walters5/Intercom/README.md

# Intercom
This is an intercom system that will be able to communicate back and forth between multiple auxiliary units.
