walters5/Intercom/Weekly Project Report (WK 10).docx

WEEKLY PROJECT REPORT (WEEK 10 – 11/28)

I. Last Week:
- Completely soldered three boards (master and slave modules)
- Tested the audio codec
- Continue programming for button
- Implemented communication between both slave and master boards
II. Next Week:
- Try finishing code for buttons
- Testing systems
- Prepare for presentation and demo
III. Issue:
- Unable to write code for channel buttons.
