walters5/Intercom/Weekly Project Report (WK 9).docx

WEEKLY PROJECT REPORT (WEEK 9 – 11/21)

I. Last Week:
- Successfully got clock signal out and make it turn on/off
- Received two boards back.
- Worked on coding for the LED and button.
- Started to solder components on the boards
II. Next Week:
- Finish soldering components
- Finish code for LED and button
III. Issue:
- No significant issue for this week.
