walters5/Intercom/Weekly Report Project (WK 8).docx

Weekly Report Project (Week 8 – 11/14)

I. Last week:
- Submitted schematic and layout
- Corrected error follow feedback from Professor Greenberg
- Already order the boards through PCB Unlimited
- Initialized all the pins on the microcontroller
II. Next week:
- Start to solder components on the boar
- Verify code functions
III. Issue:
- Unable programing to control clock signals
