walters5/Intercom/Weekly Project Report (WK 6).docx

Weekly Project Report (Week 6)

1. Last Week:
- Continued writing C code to make master device to read corresponding data from slave
- Working on schematic and PCB layout
2. Next Week:
- Finish PCB layout and check error
- Finish programming to make master-slave device connect
3. Issue:
- Need to find another library for programming the boards.
