walters5/Intercom/Weekly Project Report (WK 7).docx

Weekly Project Report (Week 7)

1. Last Week:
- We finished programming to make the master and slave connect together, then process debugging to test.
- PCB layout was finished and passed all ERC checks.
- Schematics is done
2. Next Week:
- Finish debugging master-slave
- Make microphone and speaker work corresponding to microcontroller
3. Issue:
- Re-refigured wiring between master and slave board
