walters5/Intercom/Weekly Project Report (WK 2).docx

Weekly Project Report (Week 2 – 10/08)

1. Last week:
- Completed brainstorm design for project and component choices (Chose microphone selection and Cat cable
- Clarified three terms: Must, Should, May

Must | Should | May
Two intercoms | Multiple Intercoms Unit | Wireless
Push-to-Talk | Full duplex | LCD Display Screen
Volume Control
Microphone
Speaker

- Reviewed and understand characteristic of several components: Audio codec, SPI-allows accessing, DAC, ADC.
- Estimated budget project: $30/person
- Completed homework 1: Resume (working individual).
2. Next week:
- Discuss about homework 2: project proposal.
- Complete reading practicum project.
- Decide microprocessor, standard packet size and initial cost
- Researching types of audio
- Find out where mentor graphics is accessible
3. Issue:
- Unable to get microphone selection.
