walters5/Intercom/Weekly Project Report (WK 3).docx

Weekly Project Report (Week 3 – 10/15)

1. Last week:
- Review and submit homework 2
- Figure out mentor graphic is available in Inter lab
- Discuss about project proposal
- Completed the draft for Design Architecture
- Standard packet size will not exceed 5”x5”x5”
2. Next week
- Discuss and review about Design Architecture.
- Decide which program is used to make schematic capture.
3. Issue:
- Unable to choose microcontroller
- Unable to choose types of audio
