walters5/Intercom/T-06 BOM.xlsx

Sheet: Consolidated, NO DNIs
T-06 Intercom Revised: Tuesday, November 29, 2016
1.) T-06 INTERCOM Revision: A |  |  |  | *Line cost uses unit build quantities of less than 10.
Bill Of Materials November 30,2016 0:57:27
Item | Quantity | Line Cost* | Reference | Part | PCB Footprint | DK | Manu | Manu PN
______________________________________________
1 | 13 | $1.30 | C1,C2,C3,C10,C11,C12,C13, | 0.1uF 16V | 0603 | 399-1096-1 | KEMET | C0603C104K4RACTU
 |  | $0.00 | C14,C15,C22,C23,C24,C25
2 | 1 | $0.10 | C4 | .01uF | 0603 | 1276-1919-1-ND | Samsung | CL10B103KA8NFNC
3 | 1 | $0.11 | C5 | 1uF | 0603 | 445-1604-1-ND | TDK | C1608X7R1C105K080AC
4 | 1 | $0.15 | C8 | 10uF 6.3V | 0603 | 490-6405-1 | MURATA | GRM188R60J106ME47J
5 | 3 | $1.29 | C9,C20,C21 | 47uF 6.3V | 0603 | 1276-6823-1-ND | MURATA | CL10A476MQENRE
6 | 3 | $0.81 | D1,D8,D9 | C190GKT | 0603_LED | 160-1183-1 | LITE-ON | LTST-C190GKT
7 | 6 | $1.62 | D2,D3,D4,D5,D6,D7 | C190KRKT | 0603_LED | 160-1436-1-ND | LITE-ON | LTST-C190KRKT
8 | 1 | $0.13 | F1 | 0.25_AMP | 1206 | 507-1799-1-ND | BEL FUSE | 0ZCJ0025AF2E
9 | 1 | $1.38 | J3 | 10K | POT-EVUF | P3G7103-ND | PANASONIC | EVU-F2MFL3B14
10 | 1 | $0.28 | J6 | H2X2 | H2X2 | S2012E-18-ND(partial) | SULLINS | PEC18DAAN
11 | 2 | $2.10 | J8,J7 | RJ45 | RJ45-A-2004-2-4-lps | AE10387-ND | Assmann | A-2004-2-4-LPS-N-R
12 | 1 | $0.39 | L1 | 10uH | 1210 | 490-5340-1-ND | MURATA | LQH32PN100MN0L
13 | 8 | $0.80 | P2,P5,P8,P9,P19,P20,P21, | H3 | H3 | S1012E-36-ND (partial) | SULLINS | PEC36SAAN
 |  | $0.00 | P22
14 | 7 | $0.20 | P3,P6,P10,P11,P12,P23, | H2 | H2 | S1012E-36-ND (partial) | SULLINS | PEC36SAAN
 |  | $0.00 | P24
15 | 1 | $1.05 | P4 | CMB-6544PF | MIC-CMB-6544PF | 102-1722-ND | CUI INC. | CMB-6544PF
16 | 1 | $3.53 | P7 | SPEAKER | SPKR-AST-030C0MR-R | 668-1138-ND | PUI AUDIO | AST-030C0MR-R
17 | 5 | $0.50 | R4,R5,R6,R40,R42 | 10.0K | 0603 | P10.0KHCT | PANASONIC | ERJ-3EKF1002V
18 | 3 | $0.30 | R7,R8,R38 | 0 | 0603 | P0.0GCT-ND | PANASONIC | ERJ-3GEY0R00V
19 | 2 | $0.20 | R10,R9 | 33 | 0603 | P33GCT-ND | PANASONIC | ERJ-3GEYJ330V
20 | 8 | $0.80 | R11,R12,R13,R14,R15,R16, | 3.3K | 0603 | P3.30KHCT-ND | PANASONIC | ERJ-3EKF3301V
 |  | $0.00 | R17,R19
21 | 2 | $0.20 | R32,R18 | 4.87K 1% | 0603 | P4.87KHCT | PANASONIC | ERJ-3EKF4871V
22 | 4 | $0.40 | R20,R21,R39,R41 | 100 | 0603 | P100HCT-ND | PANASONIC | ERJ-3EKF1000V
23 | 7 | $3.01 | S1,S2,S3,S4,S5,S6,S8 | SWITCH | SW-TL3301-G | EG4375CT-ND | E-SWITCH | TL3301FF160QG
24 | 1 | $0.88 | S7 | SW_DIP6 | DIPSW6 | 450-1359 | TE CONNECTIVITY | 1825002-9
25 | 1 | $2.29 | U1 | Si3000 | SO16NB | 336-1382-ND | SILICON LABS | SI3000-C-FS
26 | 1 | $4.51 | U2 | STM32L053R8 | QFP64-0.5 | 497-14654-ND | STMICRO | STM32L053R8T6
27 | 1 | $0.46 | U3 | NCP1117ST33T3G | SOT223 | NCP1117ST33T3GOSCT | ON SEMI | NCP1117ST33T3G
28 |  | $0.00 | U4 | SN65LVDS050PW | TSSOP20 | 296-12051-5-ND | TI | SN65LVDS050PW
29 | 1 | $0.43 | U12 | SN74LV245APWR | TSSOP20 | 296-3809-1-ND | TI | SN74LV245APWR
30 | 1 | $18.00 | N/A | PCB
PARTS |  | $29.22
PCB |  | $18.00
TOTAL PER UNIT: |  | $47.22

Sheet: Sheet2
T-06 Intercom Revised: Tuesday, November 29, 2016
1.) T-06 INTERCOM Revision: A |  |  | *Line cost uses unit build quantities of less than 10.
Bill Of Materials November 30,2016 0:57:27
Item | Quantity | Line Cost* | Part | PCB Footprint
______________________________________________
1 | 13 | $1.30 | 0.1uF 16V | 0603
 |  | $0.00
2 | 1 | $0.10 | .01uF | 0603
3 | 1 | $0.11 | 1uF | 0603
4 | 1 | $0.15 | 10uF 6.3V | 0603
5 | 3 | $1.29 | 47uF 6.3V | 0603
6 | 3 | $0.81 | C190GKT | 0603_LED
7 | 6 | $1.62 | C190KRKT | 0603_LED
8 | 1 | $0.13 | 0.25_AMP | 1206
9 | 1 | $1.38 | 10K | POT-EVUF
10 | 1 | $0.28 | H2X2 | H2X2
11 | 2 | $2.10 | RJ45 | RJ45-A-2004-2-4-lps
12 | 1 | $0.39 | 10uH | 1210
13 | 8 | $0.80 | H3 | H3
 |  | $0.00
14 | 7 | $0.20 | H2 | H2
 |  | $0.00
15 | 1 | $1.05 | CMB-6544PF | MIC-CMB-6544PF
16 | 1 | $3.53 | SPEAKER | SPKR-AST-030C0MR-R
17 | 5 | $0.50 | 10.0K | 0603
18 | 3 | $0.30 | 0 | 0603
19 | 2 | $0.20 | 33 | 0603
20 | 8 | $0.80 | 3.3K | 0603
 |  | $0.00
21 | 2 | $0.20 | 4.87K 1% | 0603
22 | 4 | $0.40 | 100 | 0603
23 | 7 | $3.01 | SWITCH | SW-TL3301-G
24 | 1 | $0.88 | SW_DIP6 | DIPSW6
25 | 1 | $2.29 | Si3000 | SO16NB
26 | 1 | $4.51 | STM32L053R8 | QFP64-0.5
27 | 1 | $0.46 | NCP1117ST33T3G | SOT223
28 |  | $0.00 | SN65LVDS050PW | TSSOP20
29 | 1 | $0.43 | SN74LV245APWR | TSSOP20
30 | 1 | $18.00 | PCB
PARTS |  | $29.22
PCB |  | $18.00
TOTAL PER UNIT: |  | $47.22

Sheet: T06-SCHEMATIC-INTERCOM-REVA
T-06 Intercom Revised: Tuesday, November 29, 2016
1.) T-06 INTERCOM Revision: A
Bill Of Materials November 30,2016 0:57:27
Item | Quantity | Reference | Part | PCB Footprint | DK | Manu | Manu PN
______________________________________________
1 | 13 | C1,C2,C3,C10,C11,C12,C13, | 0.1uF 16V | 603 | 399-1096-1 | KEMET | C0603C104K4RACTU
 |  | C14,C15,C22,C23,C24,C25
2 | 1 | C4 | .01uF | 603 | 1276-1919-1-ND | Samsung | CL10B103KA8NFNC
3 | 1 | C5 | 1uF | 603 | 445-1604-1-ND | TDK | C1608X7R1C105K080AC
4 | 27 | R1,R2,R3,C6,C7,D10,D11, | DNI | 603
 |  | C16,C17,C18,C19,R22,R23,
 |  | R24,R25,R26,C26,R27,R28,
 |  | R29,R30,R31,R33,R34,R35,
 |  | R36,R37
5 | 1 | C8 | 10uF 6.3V | 603 | 490-6405-1 | MURATA | GRM188R60J106ME47J
6 | 3 | C9,C20,C21 | 47uF 6.3V | 603 | 1276-6823-1-ND | MURATA | CL10A476MQENRE
7 | 3 | D1,D8,D9 | C190GKT | 0603_LED | 160-1183-1 | LITE-ON | LTST-C190GKT
8 | 6 | D2,D3,D4,D5,D6,D7 | C190KRKT | 0603_LED | 160-1436-1-ND | LITE-ON | LTST-C190KRKT
9 | 4 | FID1,FID2,FID3,FID4 | DNI | FIDUCIAL
10 | 1 | F1 | 0.25_AMP | 1206 | 507-1799-1-ND | BEL FUSE | 0ZCJ0025AF2E
11 | 1 | JP1 | DNI | H8 | S1012E-36-ND (partial) | SULLINS | PEC36SAAN
12 | 1 | JP2 | DNI | H6
13 | 5 | J1,J2,J9,J10,J11 | DNI | H1
14 | 1 | J3 | 10K | POT-EVUF | P3G7103-ND | PANASONIC | EVU-F2MFL3B14
15 | 1 | J4 | STEREO JACK | JACK-SJ-2509N | CP-M2509N-ND | CUI INC. | MJ-2509N
16 | 1 | J5 | DNI | CON_PJ102AH | CP1-023 | CUI STACK | PJ1-023
17 | 1 | J6 | H2X2 | H2X2 | S2012E-18-ND(partial) | SULLINS | PEC18DAAN
18 | 2 | J8,J7 | RJ45 | RJ45-A-2004-2-4-lps | AE10387-ND | Assmann | A-2004-2-4-LPS-N-R
19 | 1 | L1 | 10uH | 1210 | 490-5340-1-ND | MURATA | LQH32PN100MN0L
20 | 4 | MH1,MH2,MH3,MH4 | DNI | MH250-156
21 | 1 | P1 | DNI | TAG-10-CLIPS
22 | 8 | P2,P5,P8,P9,P19,P20,P21, | H3 | H3 | S1012E-36-ND (partial) | SULLINS | PEC36SAAN
 |  | P22
23 | 7 | P3,P6,P10,P11,P12,P23, | H2 | H2 | S1012E-36-ND (partial) | SULLINS | PEC36SAAN
 |  | P24
24 | 1 | P4 | CMB-6544PF | MIC-CMB-6544PF | 102-1722-ND | CUI INC. | CMB-6544PF
25 | 1 | P7 | SPEAKER | SPKR-AST-030C0MR-R | 668-1138-ND | PUI AUDIO | AST-030C0MR-R
26 | 4 | P13,P14,P15,P16 | DNI | H1 | S1012E-36(partial) | SULLINS | PEC36SAAN(partial)
27 | 1 | P17 | DNI | H2 | S1012E-36-ND (partial) | SULLINS | PEC36SAAN
28 | 1 | P18 | DNI | USB-897 | WM17113-ND | MOLEX | 67068-8000
29 | 2 | Q2,Q1 | DNI | SOT23
30 | 5 | R4,R5,R6,R40,R42 | 10.0K | 603 | P10.0KHCT | PANASONIC | ERJ-3EKF1002V
31 | 3 | R7,R8,R38 | 0 | 603 | P0.0GCT-ND | PANASONIC | ERJ-3GEY0R00V
32 | 2 | R10,R9 | 33 | 603 | P33GCT-ND | PANASONIC | ERJ-3GEYJ330V
33 | 8 | R11,R12,R13,R14,R15,R16, | 3.3K | 603 | P3.30KHCT-ND | PANASONIC | ERJ-3EKF3301V
 |  | R17,R19
34 | 2 | R32,R18 | 4.87K 1% | 603 | P4.87KHCT | PANASONIC | ERJ-3EKF4871V
35 | 4 | R20,R21,R39,R41 | 100 | 603 | P100HCT-ND | PANASONIC | ERJ-3EKF1000V
36 | 7 | S1,S2,S3,S4,S5,S6,S8 | SWITCH | SW-TL3301-G | EG4375CT-ND | E-SWITCH | TL3301FF160QG
37 | 1 | S7 | SW_DIP6 | DIPSW6 | 450-1359 | TE CONNECTIVITY | 1825002-9
38 | 1 | U1 | Si3000 | SO16NB | 336-1382-ND | SILICON LABS | SI3000-C-FS
39 | 1 | U2 | STM32L053R8 | QFP64-0.5 | 497-14654-ND | STMICRO | STM32L053R8T6
40 | 1 | U3 | NCP1117ST33T3G | SOT223 | NCP1117ST33T3GOSCT | ON SEMI | NCP1117ST33T3G
41 | 1 | U4 | SN65LVDS050PW | TSSOP20 | 296-12051-5-ND | TI | SN65LVDS050PW
42 | 1 | U5 | DNI | SO16
43 | 1 | U6 | DNI | SO14
44 | 1 | U7 | DNI | SO8
45 | 3 | U8,U9,U10 | DNI | SOT363
46 | 1 | U11 | DNI | SSOP16-GN | 768-1135-1-ND | FTDI | FT230XS-R
47 | 1 | U12 | SN74LV245APWR | TSSOP20 | 296-3809-1-ND | TI | SN74LV245APWR
48 | 1 | Y1 | DNI | XTAL-3.2X2.5 | 887-1799-1-ND | TXC | 7V-16.000MAAV-T
