walters5/Intercom/T06 Test plan.docx

1.0. INTRODUCTION
  1.1. This Document
  1.2. Conduct of the System Tests
  1.3. Recording of Results, Witnessing, and Authorities
2.0. REFERENCE DOCUMENTS
  2.1. Design Documentation
    2.1.1. STM32L053R8 Datasheet
    2.1.2. Si3000 Audio Codec Datasheet
    2.1.3. System Schematic
    2.1.4. Block Diagram
3.0. PRETEST PREPARATION
  3.1. Test Equipment
    3.1.1. Oscilloscope
    3.1.2. Multimeter
    3.1.3. Developer board
    3.1.4. Computer/Laptop
  3.2. Test Setup
4.0. SYSTEM TESTS
  4.1. Functional Checks
    4.1.1. Power supply
    4.1.2. User buttons
    4.1.3. Microphone and speaker
    4.1.4. Volume control knob
  4.2. Integration Test
    4.2.1. Si3000 Audio Codec (See Test Case)
    4.2.2. STM32L053R8 Microprocessor (See Test Case)
    4.2.3. Ethernet Driver (if connected)
    4.2.4. USB Driver (if connected)
  4.3. MCLK and SCLK Clocks (See Test Case)
  4.4. Noise Filter Test

APPENDIX: Test Record Sheets

Test Writer: Binh Phan
Test Case Name: | | | | Intercom Functional Test #1 | | | | | | | Test ID #: | INTER-FT-01
Description: | | | | Verify the clock with the Si3000 audio codec and the STM32-L053R8 microprocessor. | | | | | | | Type: | Black Box White Box

Tester Information
Name of Tester: | | | | | | | | | | | Date:
Hardware Ver: | | | | 1.0 | | | | | | | Time:
Setup: | | | | Connect MCLK to pin PA_8 and SCLK to SPI2_SCK between the audio codec and microprocessor. Connect the USRBTN (Talk Button) to the processor. Connect mic (microphone) and SPKR (speaker) to codec. Power the audio codec and microprocessor. Load software to microprocessor.
Step | VDD/VD | VSSA/VA | Clock | Expected Result | Pass | Fail | | N/A | | Comments
1 | 3.3 V / 3.3 V | 0 V / 5.0 V | 8 MHz | 8 MHz clock signal from MCLK.
2 | 3.3 V / 3.3 V | 0 V / 5.0 V | 8 MHz | 8 MHz clock signal from SCLK. | | | | | | Talk button needs to be pressed for SCLK to generate a clock signal.
Overall test result:

Test Writer: Binh Phan
Test Case Name: | | Intercom Integration Test #1 | | | | | Test ID #: | INTER-INT-01
Description: | | Verify User Buttons, LEDs, Microphones, and Speakers. | | | | | Type: | Black Box

Tester Information
Name of Tester: | | | | | | | Date:
Hardware Ver: | | 1.0 | | | | | Time:
Setup: | | Connect MCLK to pin PA_8 and SCLK to SPI2_SCK between the audio codec and microprocessor. Connect all the user buttons and the LEDs to the processor. Connect mic (microphone) and SPKR (speaker) to codec. Power the audio codec and microprocessor. Load software to microprocessor.
Step | Action | Expected Result | Pass | Fail | N/A | Comments
1 | Press user USRBTN_(1-5) button(s) | LED(s) lights up on both sender and receiver board. | | | | Test each button and combination of buttons.
2 | Press user button(s) (2nd Time) | LED(s) turns off on both sender and receiver boards
3 | Hold USRBTN_6 (talk button) | SDO line of the sender starts receiving data and the speaker of the receiver turns on. | | | | Mic always on.
4 | Talk into mic | Receive voice from the receiver speaker.
5 | Release USRBTN_6 (talk button) | Stop receiving information from SDO line and turn off speaker from the receiver.
Overall test result:

ECE 411: T-6 INTERCOM: System Test Plan Project Manager: Andrew Greenberg Team Members: Lionel Diaz, Noah Harvey, Binh Phan, Tyler Seitz and Matthew Walters November 23, 2016
