walters5/Intercom/Schematics/T06-SCHEMATIC-INTERCOM-REVA.pdf

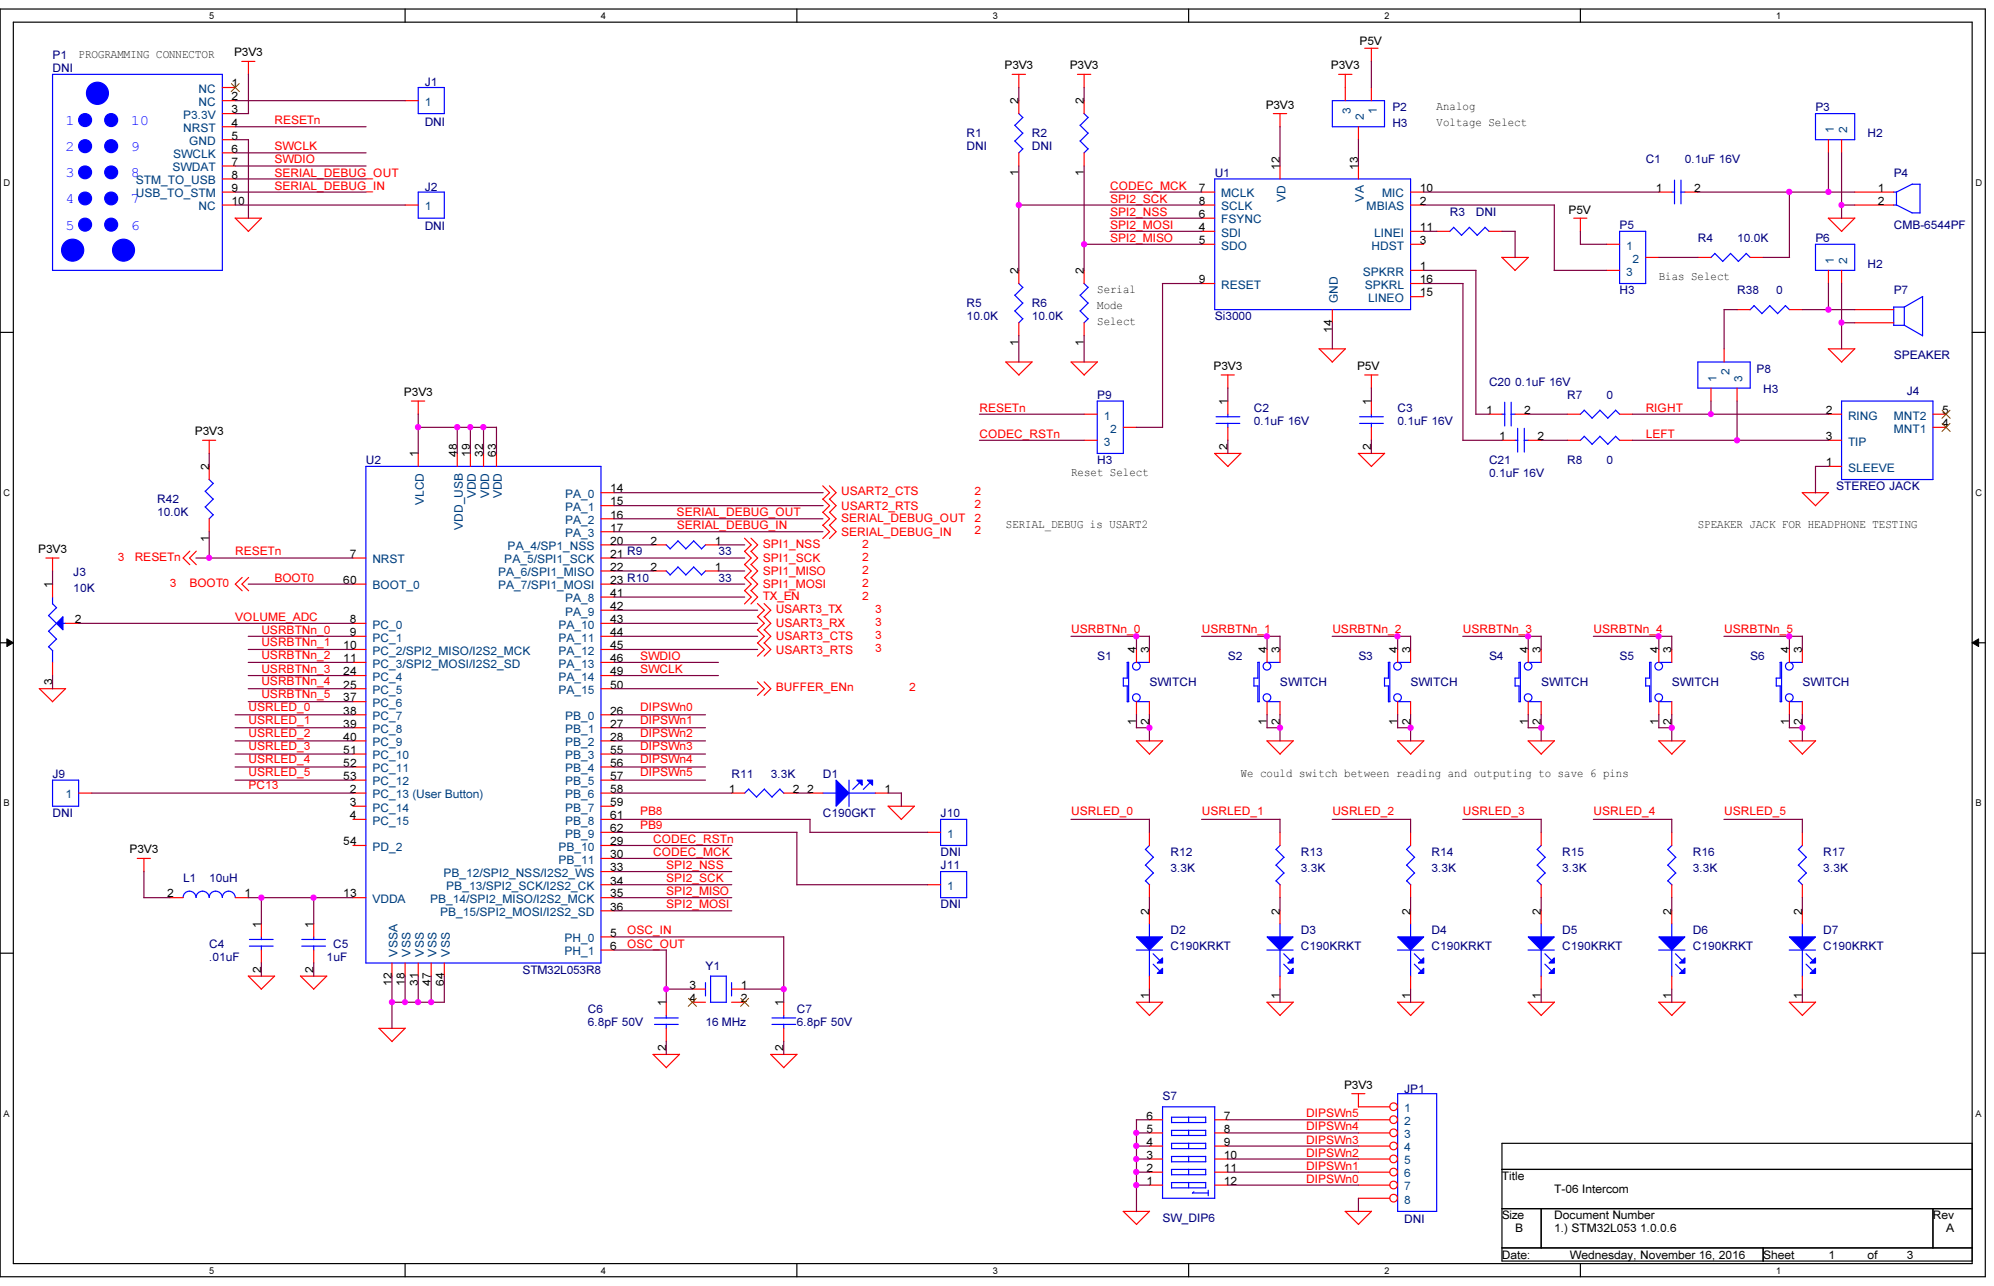
[picture p25: page 1]

We could switch between reading and outputing to save 6 pins

5 | 8 DIPSWn4
4 | DIPSWn3 9
3 | 10 DIPSWn2
2 | 11 DIPSWn1

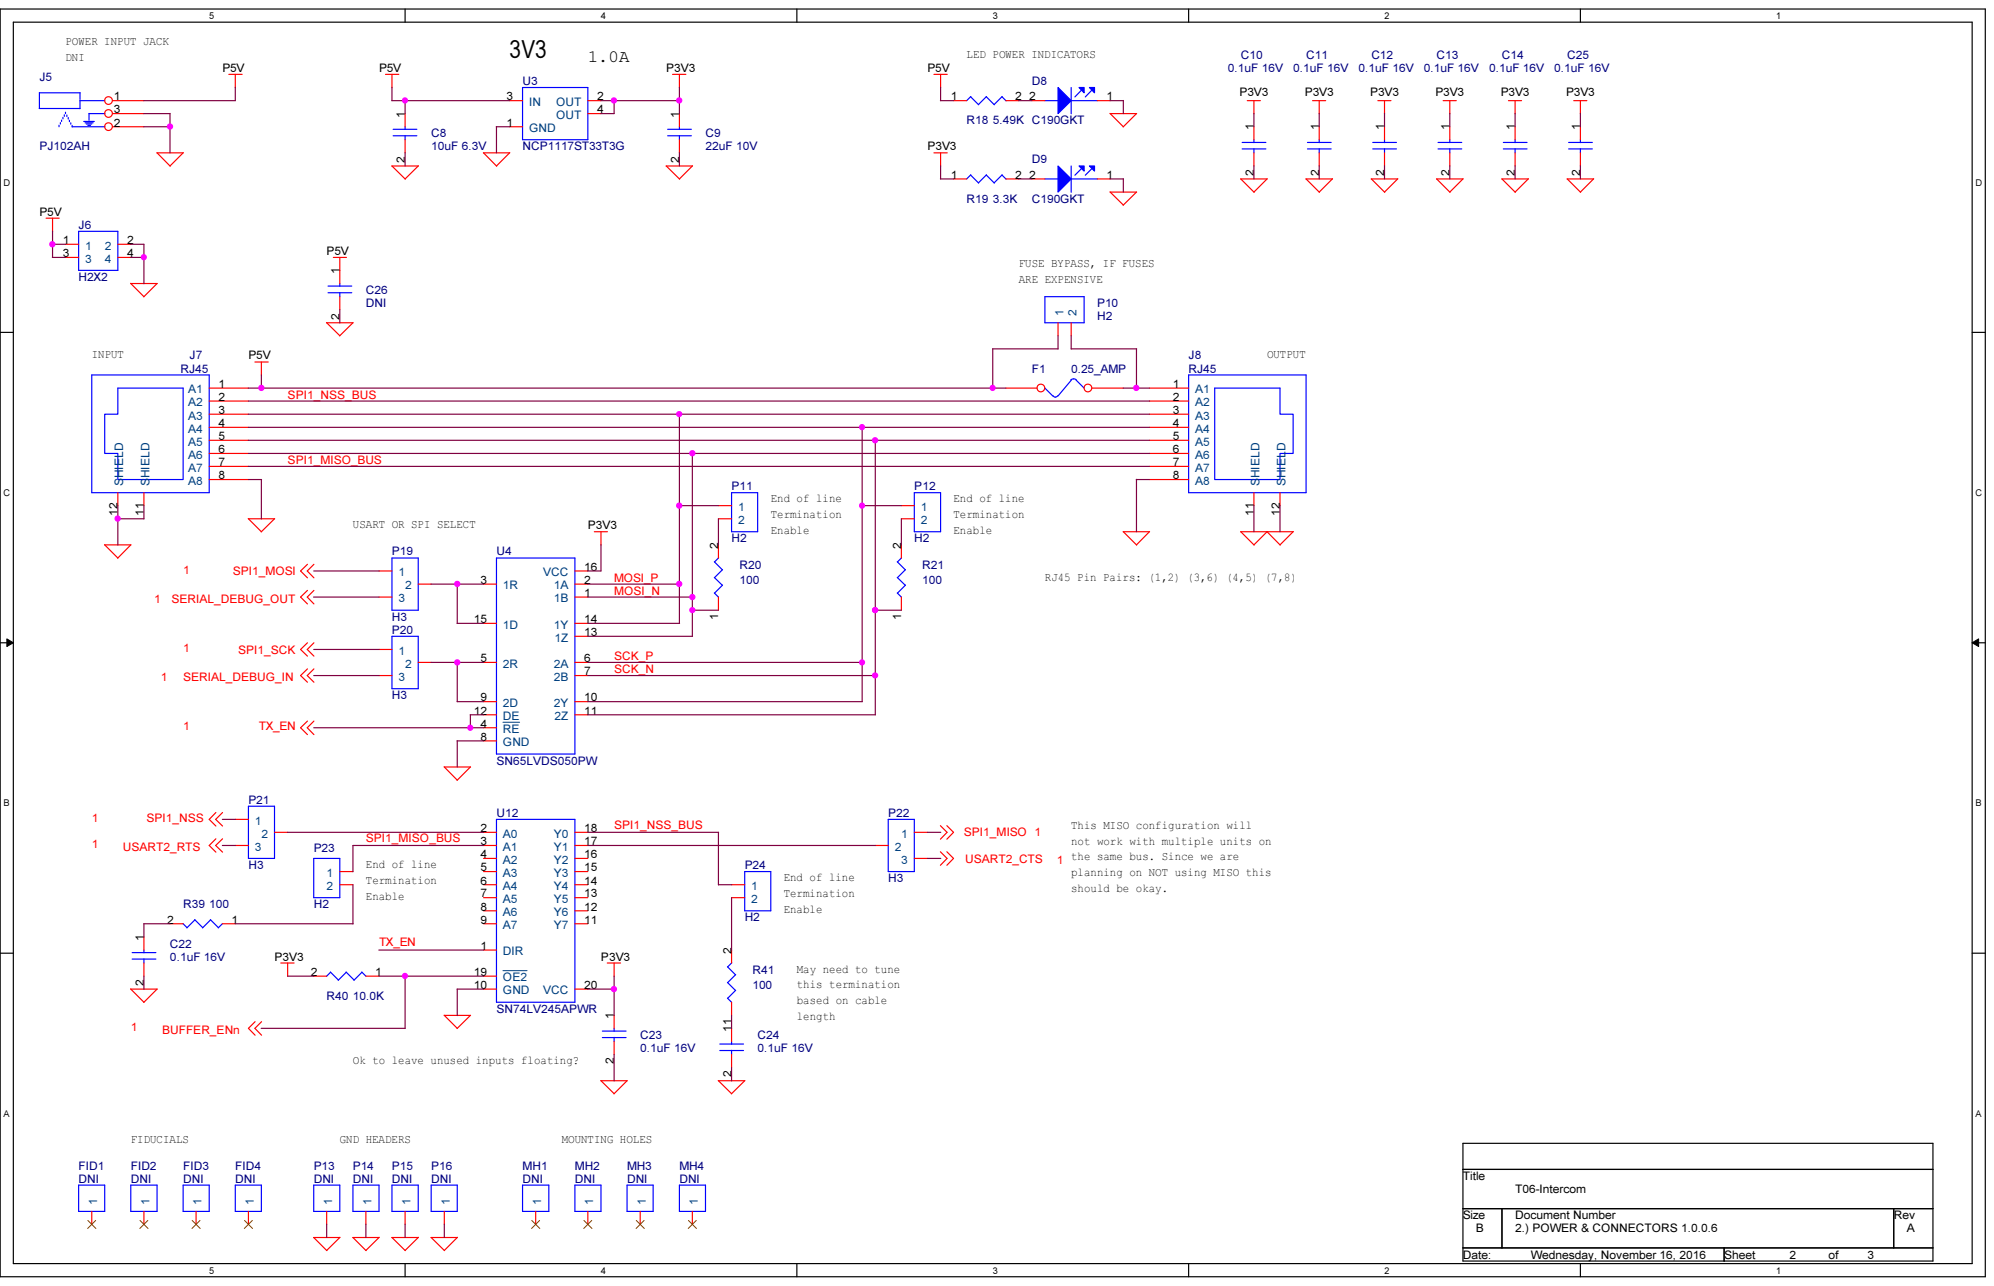
[picture p26: page 2]

FUSE BYPASS, IF FUSES
ARE EXPENSIVE

7 SPI1_MISO_BUS | | | | 7
8 | | P11 | | 8

USART OR SPI SELECT

15 | MOSI_N 1

9 | SCK_N 7

This MISO configuration will
not work with multiple units on
the same bus. Since we are
planning on NOT using MISO this
should be okay.

May need to tune
this termination
based on cable
length

Ok to leave unused inputs floating?

2.) POWER & CONNECTORS 1.0.0.6 | A

Wednesday, November 16, 2016 | 2 3

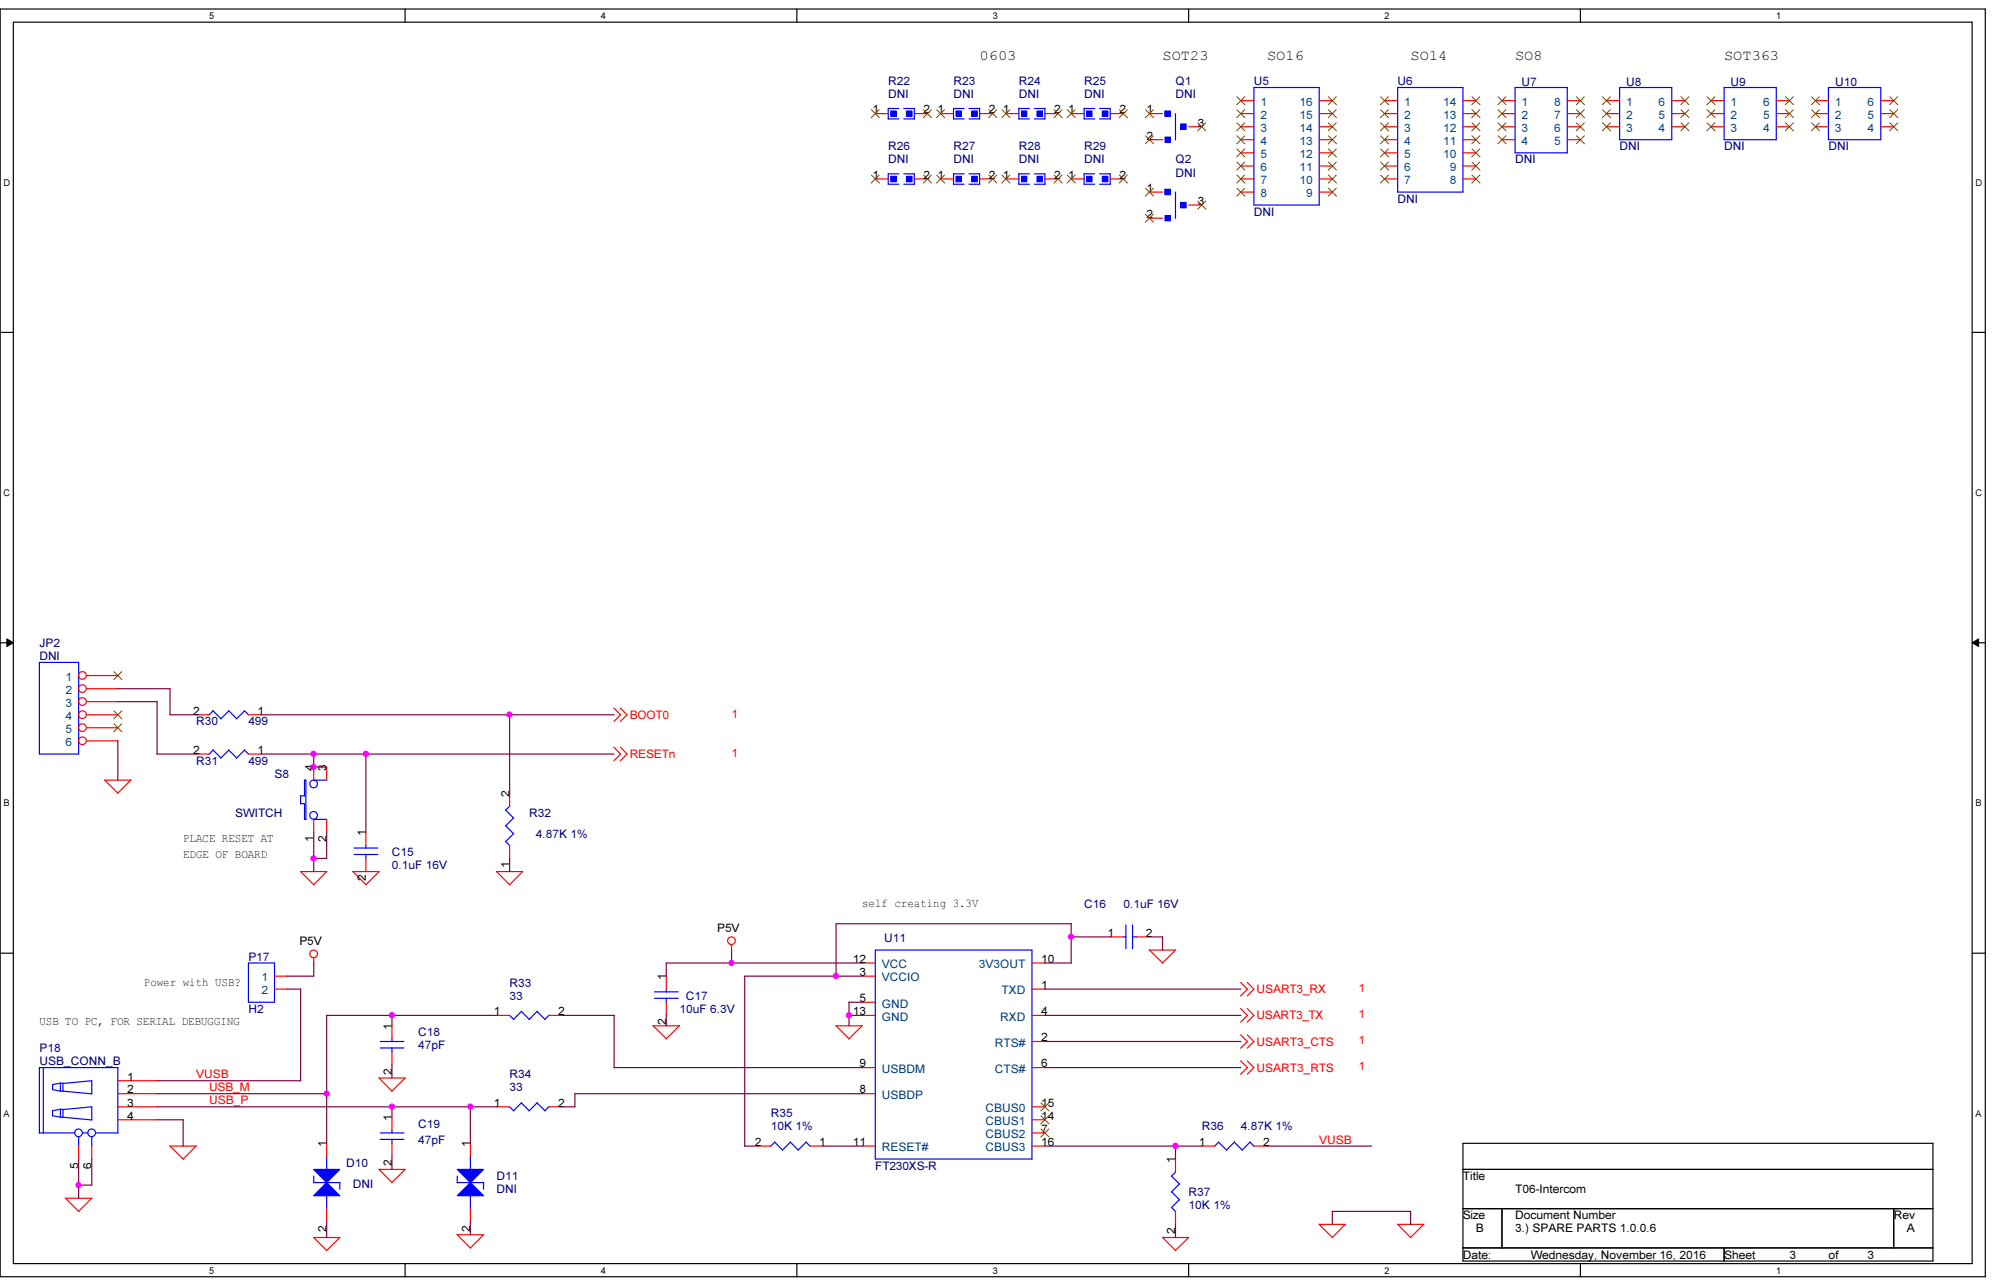
[picture p27: page 3]

USB TO PC, FOR SERIAL DEBUGGING

3.) SPARE PARTS 1.0.0.6 | A

Wednesday, November 16, 2016 | 3 3
