walters5/Intercom/(list of files, drawings)

Other design files:
PCB Layout/T06-PCB Layout-Intercom-RevA.pcb
Schematics/T06-SCHEMATIC-INTERCOM-REVA.DSN
