walters5/Intercom/(commit log)

2016-10-22 Create mbed Slave Device Reply Code
2016-10-22 Rename mbed Slave Device Reply Code to T-6 Slave Device Reply Code
2016-10-22 Create T-6 SPI Master Code
2016-11-03 Schematics.
    Not finalized. Currently no DRC errors present. Need to add provisions for UART control of wire buses. Fix microphone biasing. As well as add pullup on MOSI or RX lines of UART. AC termination for single ended signals on main bus, add tristate buffer to NSS signal. DC blocking caps for speaker AC drive.
    [INTERCOM_REVA_2.DSN]
2016-11-03 Schematics PDF
2016-11-11 Rename file
    [T06-Schematic- Intercom RevA.DSN]
2016-11-11 Made changes to schematics, mainly for DK numbers and manufactuers part numbers.
    [T06-SCHEMATIC-INTERCOM-REVA.DSN]
2016-11-11 Moving schematic files into correct directory
    [T06-SCHEMATIC-INTERCOM-REVA.DSN]
2016-11-11 Added USART support into Schematics. Fixed PCB Decal references and created them as needed. Added option for termination of single ended signals. Added tristate transciever for NSS/RTS and MISO/CTS s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
    [T06-SCHEMATIC-INTERCOM-REVA.DSN, t06-schematic-intercom-reva.opj]
2016-11-11 Preliminary part placement. Updated schematics, adding a few caps and other miscellanous futureproofings.
    [T06-PCB Layout-Intercom-RevA.pcb, T06-SCHEMATIC-INTERCOM-REVA.DSN, T06-SCHEMATIC-INTERCOM-REVA.sch, t06-schematic-intercom-reva.opj]
2016-11-11 PCB is finished, passes all ERC checks, Gerbers generated. Board was made to be just under 20 square inches to avoid increase to cost. Schematics ran against pcb, netlist verified.
    [T06-PCB Layout-Intercom-RevA.pcb, T06-SCHEMATIC-INTERCOM-REVA.DSN, T06-SCHEMATIC-INTERCOM-REVA.sch, t06-schematic-intercom-reva.opj]
2016-11-17 created pdf of pcb gerbers for easy viewing. Some were reporting issues with Gerbv program.
    [T06-PCB Layout-Intercom-RevA.pcb, T06-SCHEMATIC-INTERCOM-REVA.DSN]
2016-11-30 Fixed board outline in PADS file.
    [T06-PCB Layout-Intercom-RevA.pcb]
2016-11-30 Generated new version of BOM.
    [T-06 BOM.xlsx]
2016-12-09 updated bom with purchase costs.
    [T-06 BOM.xlsx]
